wujiyan004/Underground_Start_Link/image/CANUWB8_仿真图_(底层).png

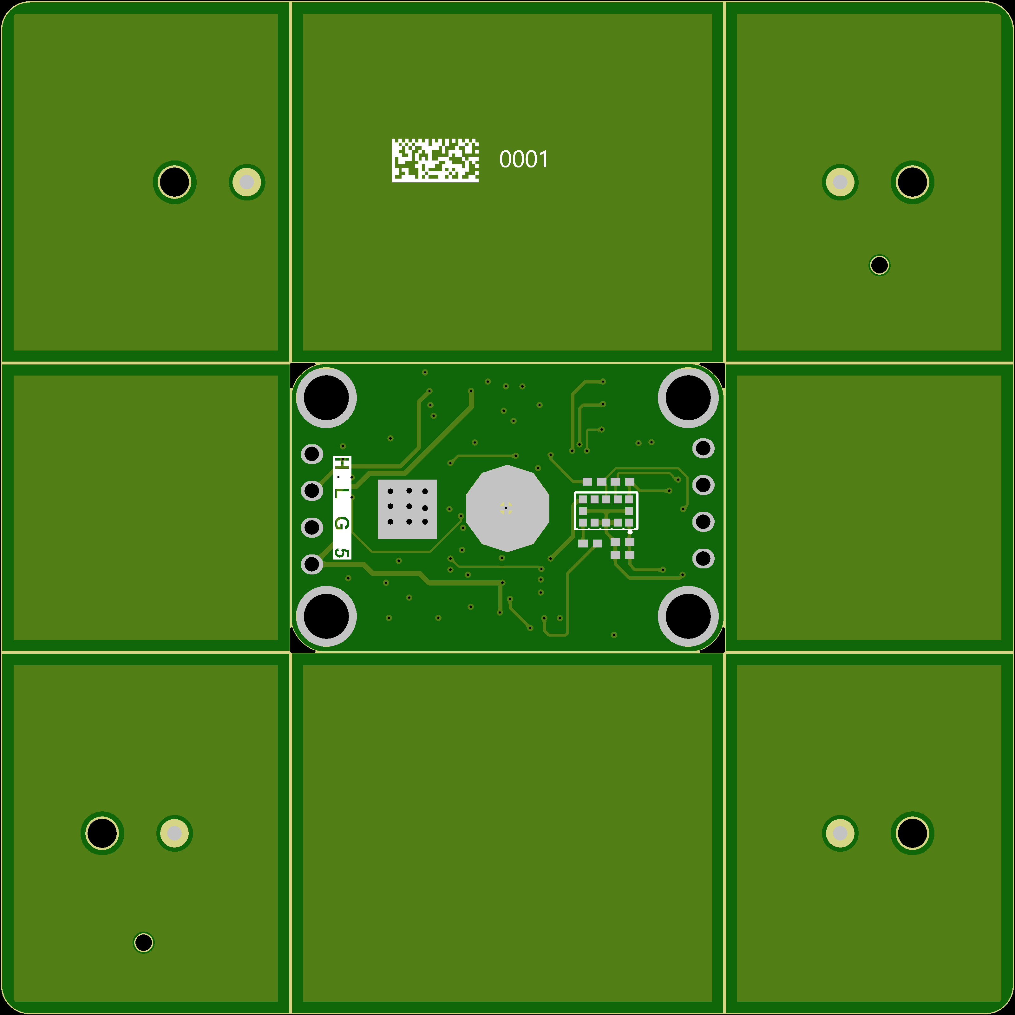
image/CANUWB8_仿真图_(底层).png
