wujiyan004/Underground_Start_Link/image/db.png

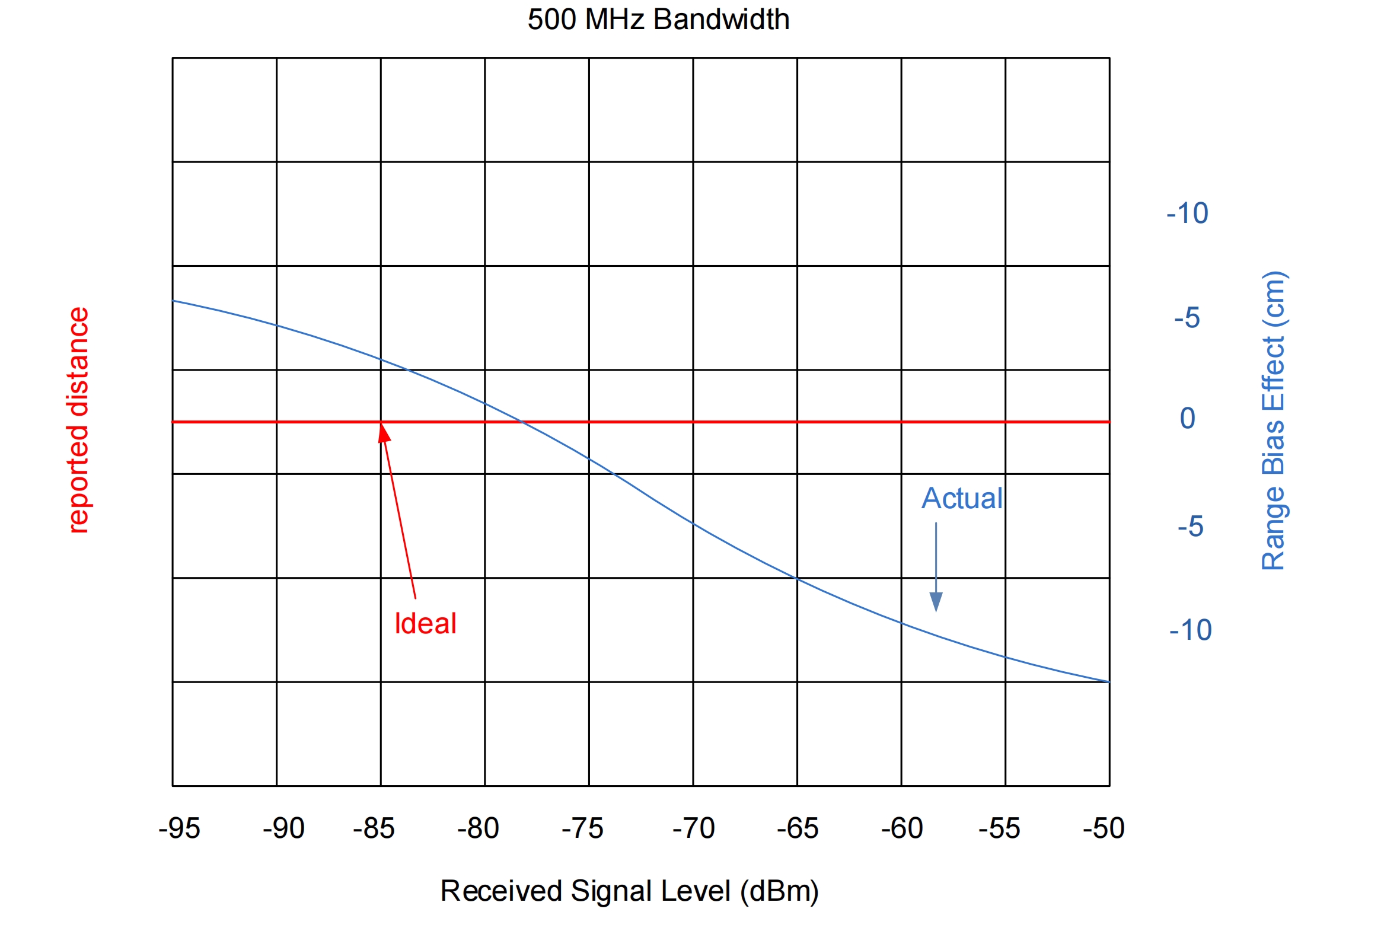
image/db.png
