wujiyan004/Underground_Start_Link/image/pingmu.jpg

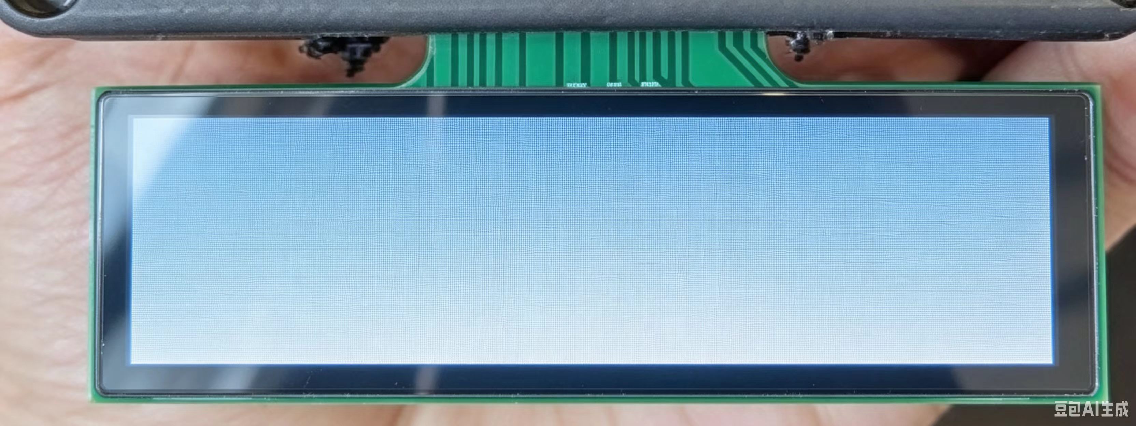
image/pingmu.jpg
