wujiyan004/Underground_Start_Link/image/ppm.png

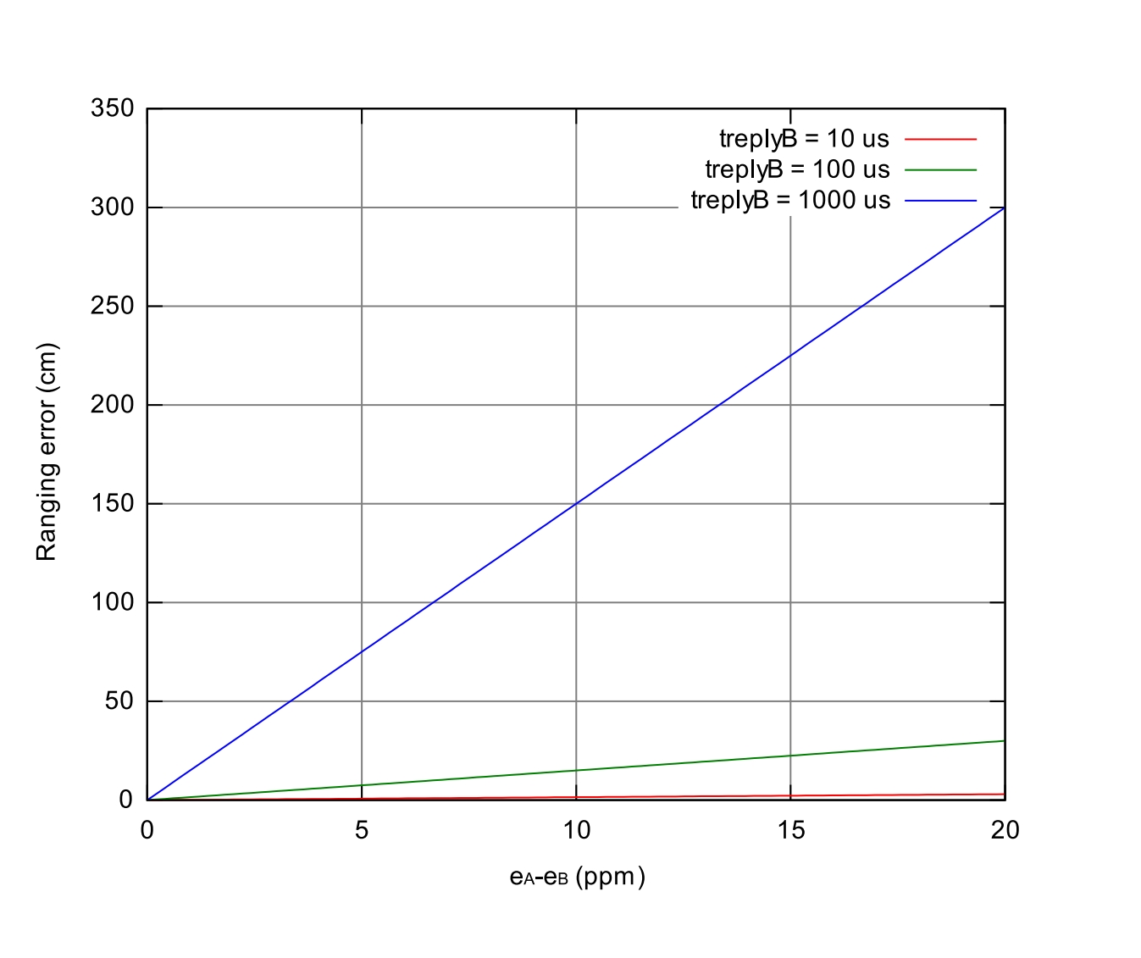
image/ppm.png
