wujiyan004/Underground_Start_Link/image/r4.jpg

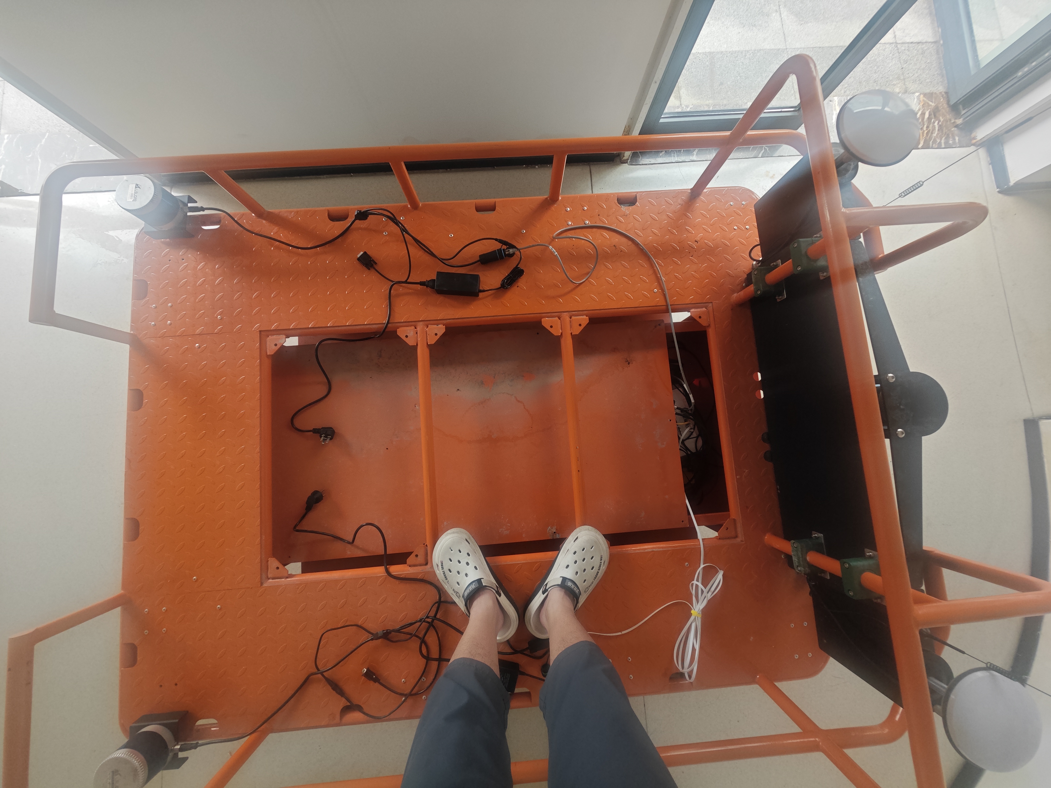
image/r4.jpg
