wujiyan004/Underground_Start_Link/image/RTK_Start_link.jpg

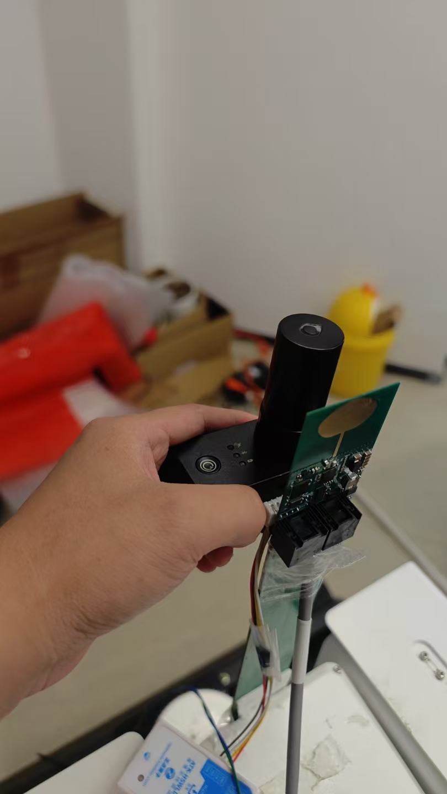
image/RTK_Start_link.jpg
