wujiyan004/Underground_Start_Link/image/xl3.jpg

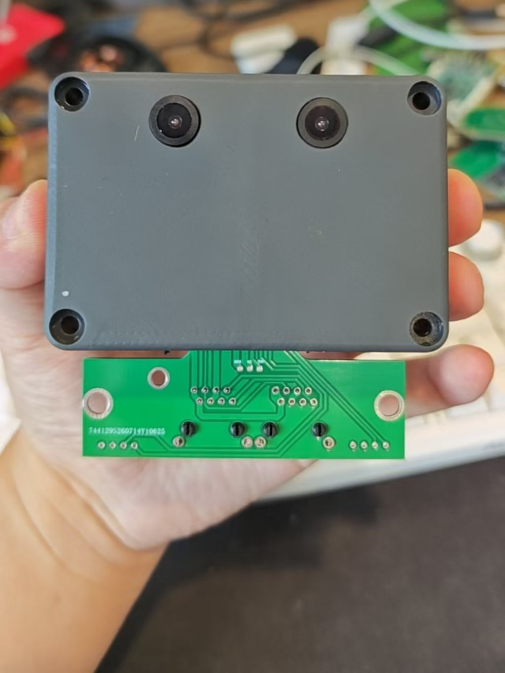
image/xl3.jpg
