wujiyan004/Underground_Start_Link/image/公式1.png

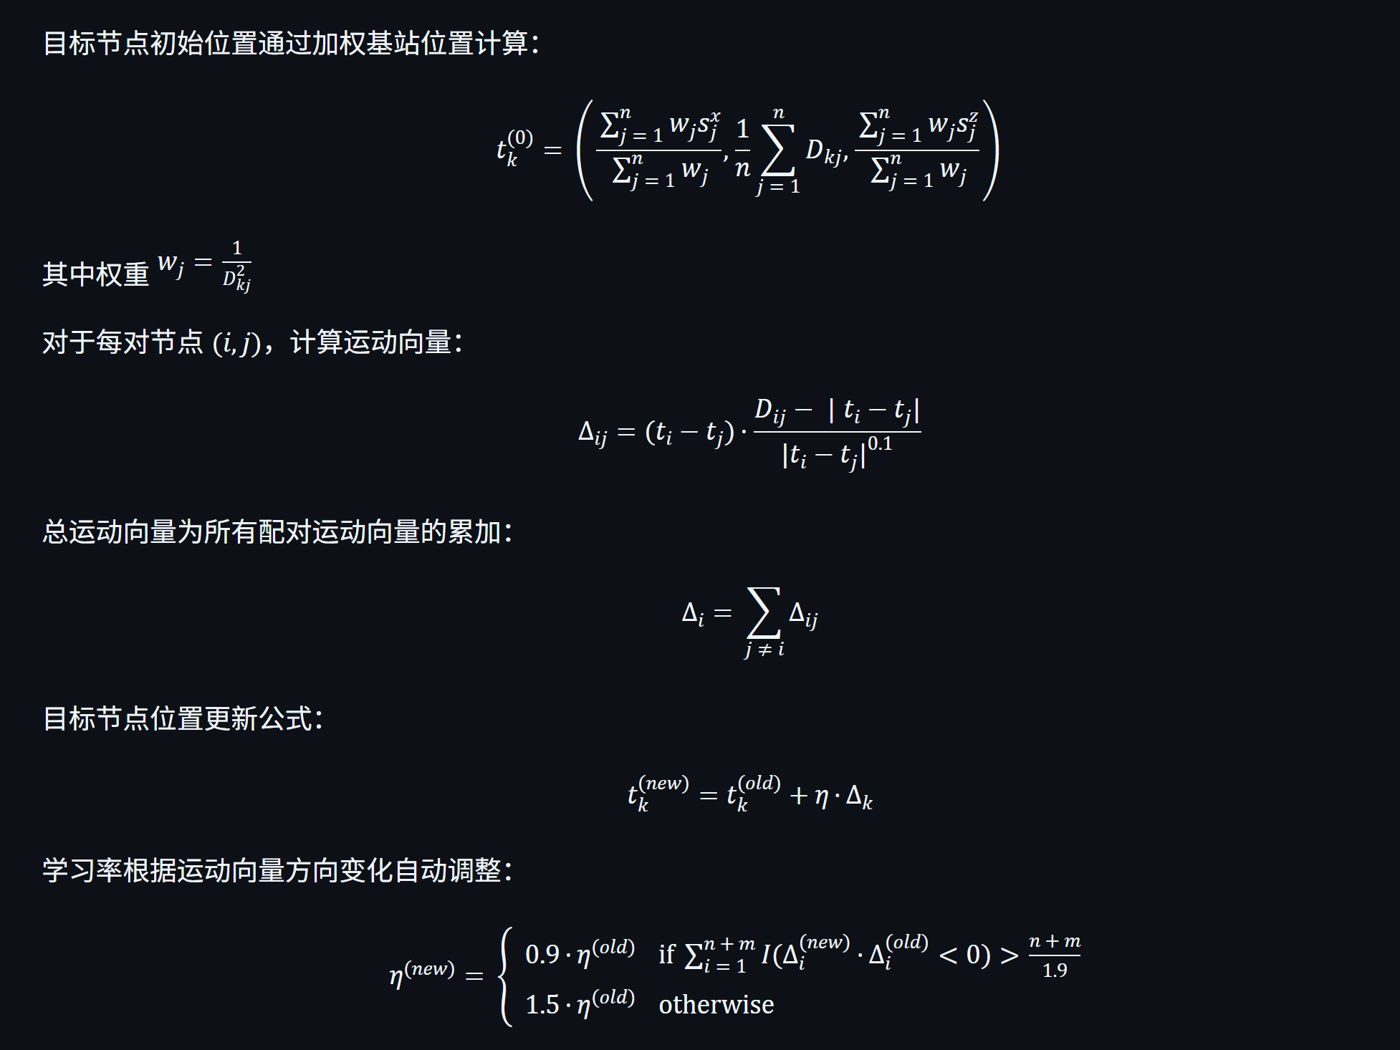
image/公式1.png
