wujiyan004/Underground_Start_Link/image/室内定位.png

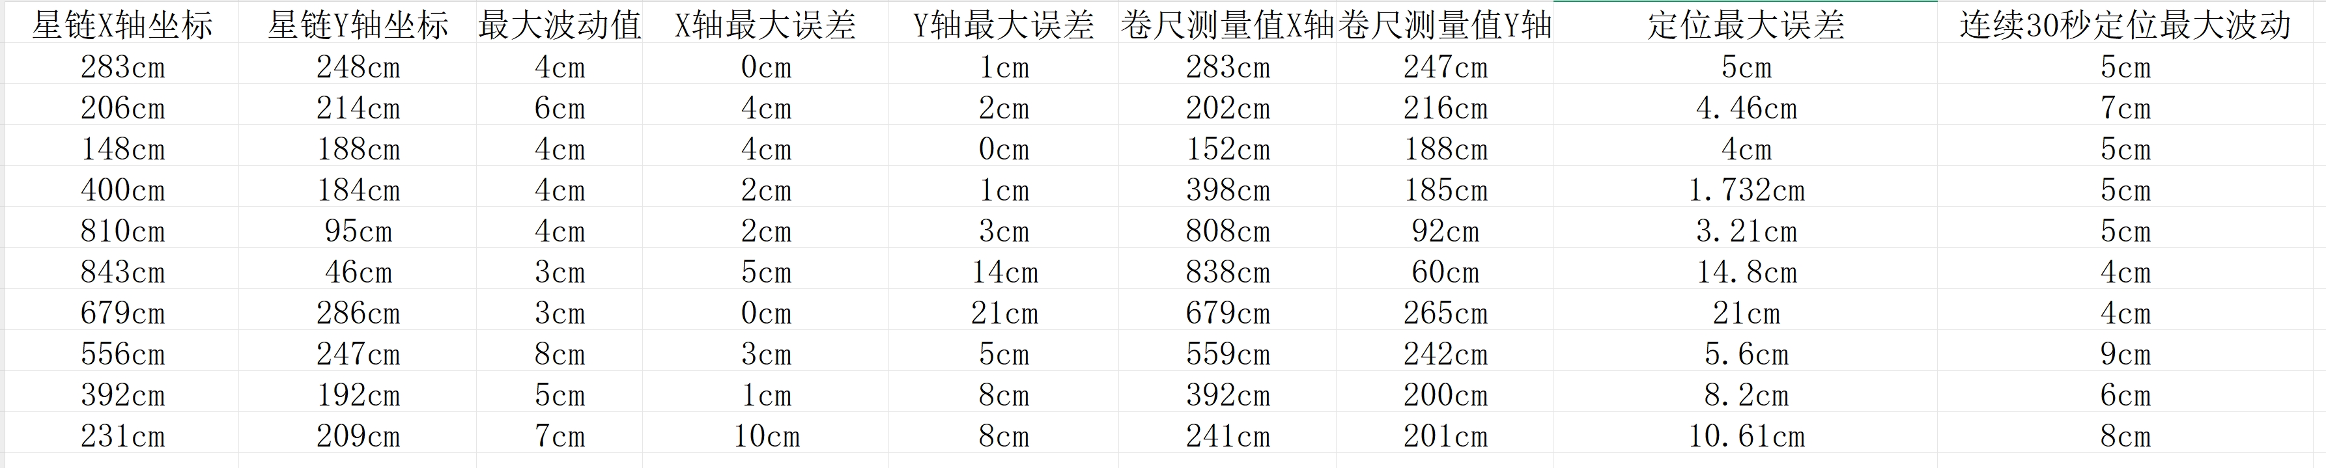
image/室内定位.png
