wujiyan004/Underground_Start_Link/(commit log)

2026-07-12 1
    1
    [跟随BOM清单.xls]
2026-07-17 666
    666
    [跟随BOM清单.xls]
